Rotario/toolTorque/Orders.xlsx

Part | Value | Device | Package | Description
C1 | 0.1uF | 0.1UF-25V-5%(0603) | 0603-CAP | CAP-08604
C2 | 0.1uF | 0.1UF-25V-5%(0603) | 0603-CAP | CAP-08604 | M | 11 | 81-GRM033R60J104JE9D | GRM033R60J104JE19D | Murata | Multilayer Ceramic Capacitors MLCC - SMD/SMT .1UF 6.3V 5% 0201 | RoHS Compliant |  | 4 | £0.082 | £0.33
C3 | 0.1uF | 0.1UF-25V-5%(0603) | 0603-CAP | CAP-08604
C5 | 0.1uF | 0.1UF-25V-5%(0603) | 0603-CAP | CAP-08604
C6 | 10uF | 10UF50V20%(1210) | 1210 | CAP-09824 | M | 12 | 963-EMK325BJ106MN-T | EMK325BJ106MN-T | Taiyo Yuden | Multilayer Ceramic Capacitors MLCC - SMD/SMT 1210 16VDC 10uF 20% X5R | RoHS Compliant |  | 2 | £0.295 | £0.59
C7 | 10uF | 10UF50V20%(1210) | 1210 | CAP-09824
J1 | DCJ0202 | DCJ0202 | DCJ0202 | DC POWER JACK | M | 10 | 502-RAPC722BKZ | RAPC722BKZ | Switchcraft | DC Power Connectors BKZ Locking Series 2.0mm RAPC Mount | RoHS Compliant | New Product | 3 | £1.87 | £5.61
JP2 | 53047-0210 | 53047-0210 | 53047-0210 | Molex Picoblade 3 way PCB Header
L1 | 3.3uH | INDUCTOR0805-IND | 805 | Inductors | M | 13 | 810-KLZ2012MHR3R3HTD | KLZ2012MHR3R3HTD25 | TDK | Fixed Inductors 3.3uH 2MHz 20% 2012 AEC-Q200 | RoHS Compliant |  | 1 | £0.254 | £0.25
Q1 | MMBT4403 | TRANSISTOR_PNPMMBT4403 | SOT23-3 | Generic PNP BJT
R1 | 20k | 20KOHM1/10W1%(0603) | 0603-RES | RES-09383 | M | 14 | 660-RN73R1JTD2002B25 | RN73R1JTTD2002B25 | KOA Speer | Thin Film Resistors - SMD 20K ohm 0.1% 25 ppm | RoHS Compliant | New Product | 1 | £0.385 | £0.39
R2 | 8.2K | 8.2KOHM-1/10W-5%(0603) | 0603-RES | RES-10646 | M | 15 | 71-CRCW06038K20FKEAC | CRCW06038K20FKEAC | Vishay | Thick Film Resistors - SMD 1/10Watt 8.2Kohms 1% Commercial Use | RoHS Compliant By Exemption | New Product | 1 | £0.131 | £0.13
R3 | 100 | 100OHM-1/10W-1%(0603) | 0603-RES | RES-07863 | M | 16 | 71-CRCW0603100RJNEAC | CRCW0603100RJNEAC | Vishay | Thick Film Resistors - SMD 1/10Watt 100ohms 5% Commercial Use | RoHS Compliant By Exemption | New Product | 2 | £0.082 | £0.16
R4 | 100 | 100OHM-1/10W-1%(0603) | 0603-RES | RES-07863
R5 | 10K | 10KOHM-1/10W-1%(0603)0603 | 0603-RES | RES-00824 | M | 17 | 71-CRCW060310K0FKEAC | CRCW060310K0FKEAC | Vishay | Thick Film Resistors - SMD 1/10Watt 10Kohms 1% Commercial Use | RoHS Compliant By Exemption | New Product | 1 | £0.123 | £0.12
SG2 | EFBRD24C411 | EFBRD24C411 | RS511-7620 | Piezoelectric Acoustic Transducer
SJ2 |  | JUMPER-PAD-2-NC_BY_TRACE | PAD-JUMPER-2-NC_BY_TRACE_YES_SILK
SW1 |  | SW_DIP-2 | EDG-02 | DIP SWITCH | M | 4 | 653-A6FR-2104 | A6FR-2104 | Omron | DIP Switches/SIP Switches 2 Pole Long Actuator (white) | RoHS Compliant | New Product | 3 | £0.631 | £1.89
U$1 | 53047-0410 | 53047-0410 | 53047-0410 | Molex Picoblade 4 way PCB Header
U$2 | WEMOS-D1-MINI | WEMOS-D1-MINI | WEMOS-D1-MINI | WEMOS D1 mini: Mini Wi-Fi Board based on ESP-8266 device
U1 | HX711 | HX711HX711 | SO16 |  |  |  |  |  |  | IC-12445 |  | HX711
X1 | (4DSYSTEMS)FH12-30S-0.5SH | (4DSYSTEMS)FH12-30S-0.5SH | FH12-30S-0.5SH | 0.5mm Pitch Connectors For FPC/FFC | M | 2 | 798-FH52E-30S0.5SH99 | FH52E-30S-0.5SH(99) | Hirose Electric | FFC & FPC Connectors 0.5MM 30P LNG MTL FITNG SMT VERT MNT | RoHS Compliant |  | 3 | £3.11 | £9.33
Stand off |  |  |  |  | M | 3 | 534-24283 | 24283 | Keystone Electronics | Standoffs & Spacers 4.5 HEX 10.0mm SS | RoHS Compliant |  | 12 | £1.11 | £13.32
Stand off screws |  |  |  |  | M | 9 | 608-RM2.5X6MM2701 | RM2.5x6MM 2701 | APM HEXSEAL | Screws & Fasteners | RoHS Compliant |  | 12 | £0.418 | £5.02
