Rotario/toolTorque/Mouser.xls

SHOPPING BASKET
This is not an invoice
11-Oct-19 05:20:31
 | Mouser No | Mfr. No | Manufacturer | Customer No | Description | RoHS | Lifecycle | Order Qty. | Price (GBP) | Ext.: (GBP)
1 | 649-52601-S10-8LF | 52601-S10-8LF | FCI / Amphenol |  | Headers & Wire Housings LOW PROFILE .100 SHRD HDR | RoHS Compliant |  | 5 | £1.81 | £9.05
2 | 798-FH52E-30S0.5SH99 | FH52E-30S-0.5SH(99) | Hirose Electric |  | FFC & FPC Connectors 0.5MM 30P LNG MTL FITNG SMT VERT MNT | RoHS Compliant |  | 3 | £3.11 | £9.33
3 | 534-24283 | 24283 | Keystone Electronics |  | Standoffs & Spacers 4.5 HEX 10.0mm SS | RoHS Compliant |  | 12 | £1.11 | £13.32
4 | 653-A6FR-2104 | A6FR-2104 | Omron |  | DIP Switches/SIP Switches 2 Pole Long Actuator (white) | RoHS Compliant | New Product | 3 | £0.631 | £1.89
5 | 474-TOL-14557 | TOL-14557 | SparkFun Electronics |  | SparkFun Accessories Hot-Air Rework Station - 303D | RoHS Compliant | New At Mouser | 1 | £106.47 | £106.47
6 | 578-EROP7SA | EROP7SA | Apex Tool Group |  | Pliers & Tweezers Erem 4.5" Tweezers Micro-fine Curved | Not Applicable |  | 1 | £3.94 | £3.94
7 | 590-811-100 | 811-100 | MG Chemicals |  | Chemicals COTTON SWABS (DOUBLE 100 PCS PER PKG | Not Applicable |  | 1 | £4.38 | £4.38
8 | 910-TS391AX50 | TS391AX50 | Chip Quik |  | Solder Paste No-Clean 50g Sn63/Pb37 T4 |  |  | 1 | £11.43 | £11.43
9 | 608-RM2.5X6MM2701 | RM2.5x6MM 2701 | APM HEXSEAL |  | Screws & Fasteners | RoHS Compliant |  | 12 | £0.418 | £5.02
10 | 502-RAPC722BKZ | RAPC722BKZ | Switchcraft |  | DC Power Connectors BKZ Locking Series 2.0mm RAPC Mount | RoHS Compliant | New Product | 3 | £1.87 | £5.61
11 | 81-GRM033R60J104JE9D | GRM033R60J104JE19D | Murata |  | Multilayer Ceramic Capacitors MLCC - SMD/SMT .1UF 6.3V 5% 0201 | RoHS Compliant |  | 4 | £0.082 | £0.33
12 | 963-EMK325BJ106MN-T | EMK325BJ106MN-T | Taiyo Yuden |  | Multilayer Ceramic Capacitors MLCC - SMD/SMT 1210 16VDC 10uF 20% X5R | RoHS Compliant |  | 2 | £0.295 | £0.59
13 | 810-KLZ2012MHR3R3HTD | KLZ2012MHR3R3HTD25 | TDK |  | Fixed Inductors 3.3uH 2MHz 20% 2012 AEC-Q200 | RoHS Compliant |  | 1 | £0.254 | £0.25
14 | 660-RN73R1JTD2002B25 | RN73R1JTTD2002B25 | KOA Speer |  | Thin Film Resistors - SMD 20K ohm 0.1% 25 ppm | RoHS Compliant | New Product | 1 | £0.385 | £0.39
15 | 71-CRCW06038K20FKEAC | CRCW06038K20FKEAC | Vishay |  | Thick Film Resistors - SMD 1/10Watt 8.2Kohms 1% Commercial Use | RoHS Compliant By Exemption | New Product | 1 | £0.131 | £0.13
16 | 71-CRCW0603100RJNEAC | CRCW0603100RJNEAC | Vishay |  | Thick Film Resistors - SMD 1/10Watt 100ohms 5% Commercial Use | RoHS Compliant By Exemption | New Product | 2 | £0.082 | £0.16
17 | 71-CRCW060310K0FKEAC | CRCW060310K0FKEAC | Vishay |  | Thick Film Resistors - SMD 1/10Watt 10Kohms 1% Commercial Use | RoHS Compliant By Exemption | New Product | 1 | £0.123 | £0.12
By submitting your order you agree to these terms and conditions. (https://www.mouser.co.uk/saleterms) |  |  |  |  |  |  |  |  | Merchandise Total: | £172.41
Prices are reflected at the date and time shown. |  |  |  |  |  |  |  |  | Delivery Charge: | £0.00
 |  |  |  |  |  |  |  |  | Back-order Delivery: | Estimate
