Rotario/toolTorque/TorquePotSch_SINGLEBOARD.brd

## EAGLE design TorquePotSch_SINGLEBOARD.brd (2019-12-05)

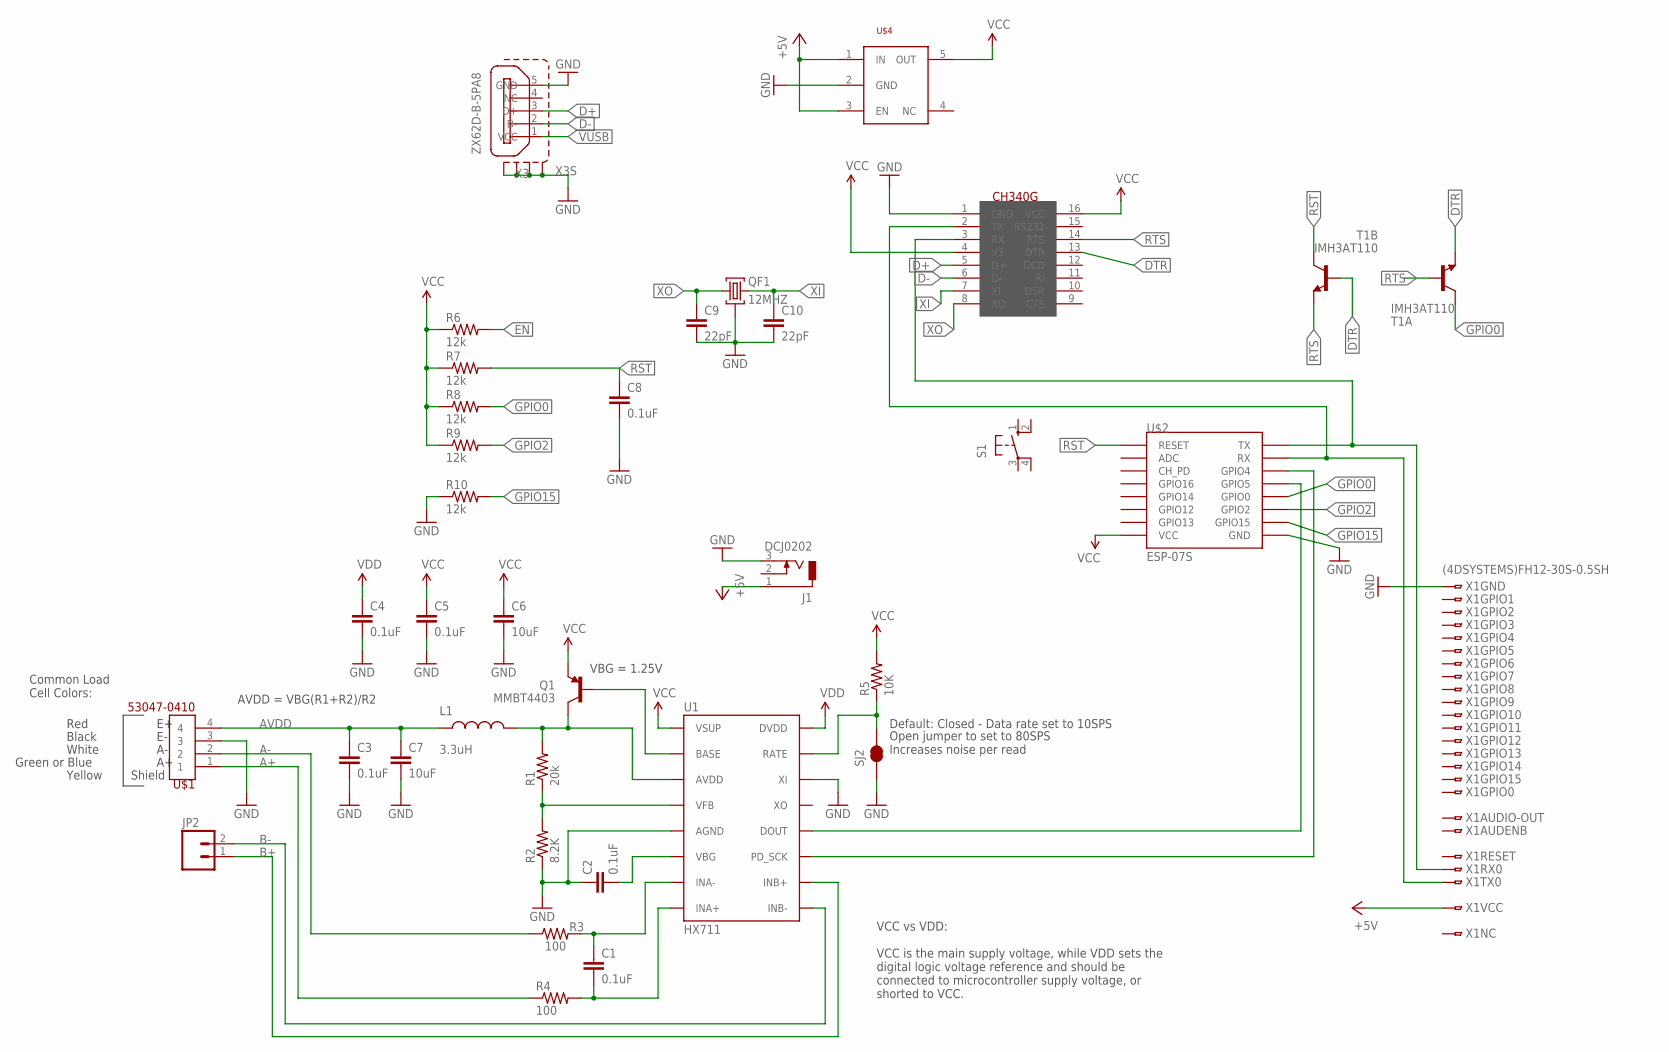
[picture p1: schematic TorquePotSch_SINGLEBOARD.sch]

Parts:
C1, C2, C3, C4, C5, C8: 0.1uF; 0603-CAP
C6, C7: 10uF; 1210
C9, C10: 22pF; 0603-CAP
J1: DCJ0202
JP2: M02PTH; 1X02
L1: 3.3uH; 0805
Q1: MMBT4403; SOT23-3
QF1: 12MHZ; HC49U
R1: 20k; 0603-RES
R2: 8.2K; 0603-RES
R3, R4: 100; 0603-RES
R5: 10K; 0603-RES
R6, R7, R8, R9, R10: 12k; R0805
S1: 10-XX; B3F-10XX
SJ2: JUMPER-PAD-2-NC_BY_TRACE; PAD-JUMPER-2-NC_BY_TRACE_YES_SILK
T1: IMH3AT110; SMT6
U1: HX711; SO16
U$1: 53047-0410
U$2: ESP-07S; ESP07S
U$3: CH340G; SOIC16
U$4: TLV755P; SOT23-5L
X1: (4DSYSTEMS)FH12-30S-0.5SH; FH12-30S-0.5SH
X3: ZX62D-B-5PA8

Connections:
+5V: J1.1, U$4.1 (IN), U$4.3 (EN), X1.26, X1.27
A+: R4.1, U$1.1
A-: R3.1, U$1.2
AVDD: C3.1, C7.1, L1.1, U$1.4
B+: JP2.1, U1.10 (INB+)
B-: JP2.2, U1.9 (INB-)
D+: U$3.5 (D+), X3.3 (D+)
D-: U$3.6 (D-), X3.2 (D-)
DTR: T1.6 (E), U$3.13 (DTR)
EN: R6.2
GND: C2.1, C3.2, C4.2, C5.2, C6.2, C7.2, C8.2, C9.2, C10.2, J1.3, QF1.2, R2.1, R10.1, SJ2.1, U1.5 (AGND), U1.14 (XI), U$1.3, U$2.GND, U$3.1 (GND), U$4.2 (GND), X1.1, X1.21, X1.25, X1.30, X3.5 (GND), X3.S1, X3.S2, X3.S3, X3.S4
GPIO0: R8.2, T1.1 (C), U$2.GPIO0
GPIO2: R9.2, U$2.GPIO2
GPIO15: R10.2, U$2.GPIO15
unnamed: R5.1, SJ2.2, U1.15 (RATE)
unnamed: C1.1, R3.2, U1.7 (INA-)
unnamed: C1.2, R4.2, U1.8 (INA+)
unnamed: Q1.1 (B), U1.2 (BASE)
unnamed: L1.2, Q1.3 (C), R1.2, U1.3 (AVDD)
unnamed: R1.1, R2.2, U1.4 (VFB)
unnamed: C2.2, U1.6 (VBG)
unnamed: U1.12 (DOUT), U$2.GPIO5
unnamed: U1.11 (PD_SCK), U$2.GPIO4
unnamed: U$2.TX, U$3.3 (RX), X1.23
unnamed: U$2.RX, U$3.2 (TX), X1.24
RST: C8.1, R7.2, U$2.REST (RESET)
RTS: U$3.14 (RTS)
VCC: C5.1, C6.1, Q1.2 (E), R5.2, R6.1, R7.1, R8.1, R9.1, U1.1 (VSUP), U$2.VCC, U$3.4 (V3), U$3.16 (VCC), U$4.5 (OUT)
VDD: C4.1, U1.16 (DVDD)
VUSB: X3.1 (VCC)
XI: C10.1, QF1.3, U$3.7 (XI)
XO: C9.1, QF1.1, U$3.8 (XO)

Notes on the sheet:
VBG = 1.25V
AVDD = VBG(R1+R2)/R2
Default: Closed - Data rate set to 10SPS
Open jumper to set to 80SPS Increases noise per read
Red
Black
White
Green or Blue
Common Load Cell Colors:
Shield
Yellow
VCC vs VDD: VCC is the main supply voltage, while VDD sets the digital logic voltage reference and should be connected to microcontroller supply voltage, or shorted to VCC.

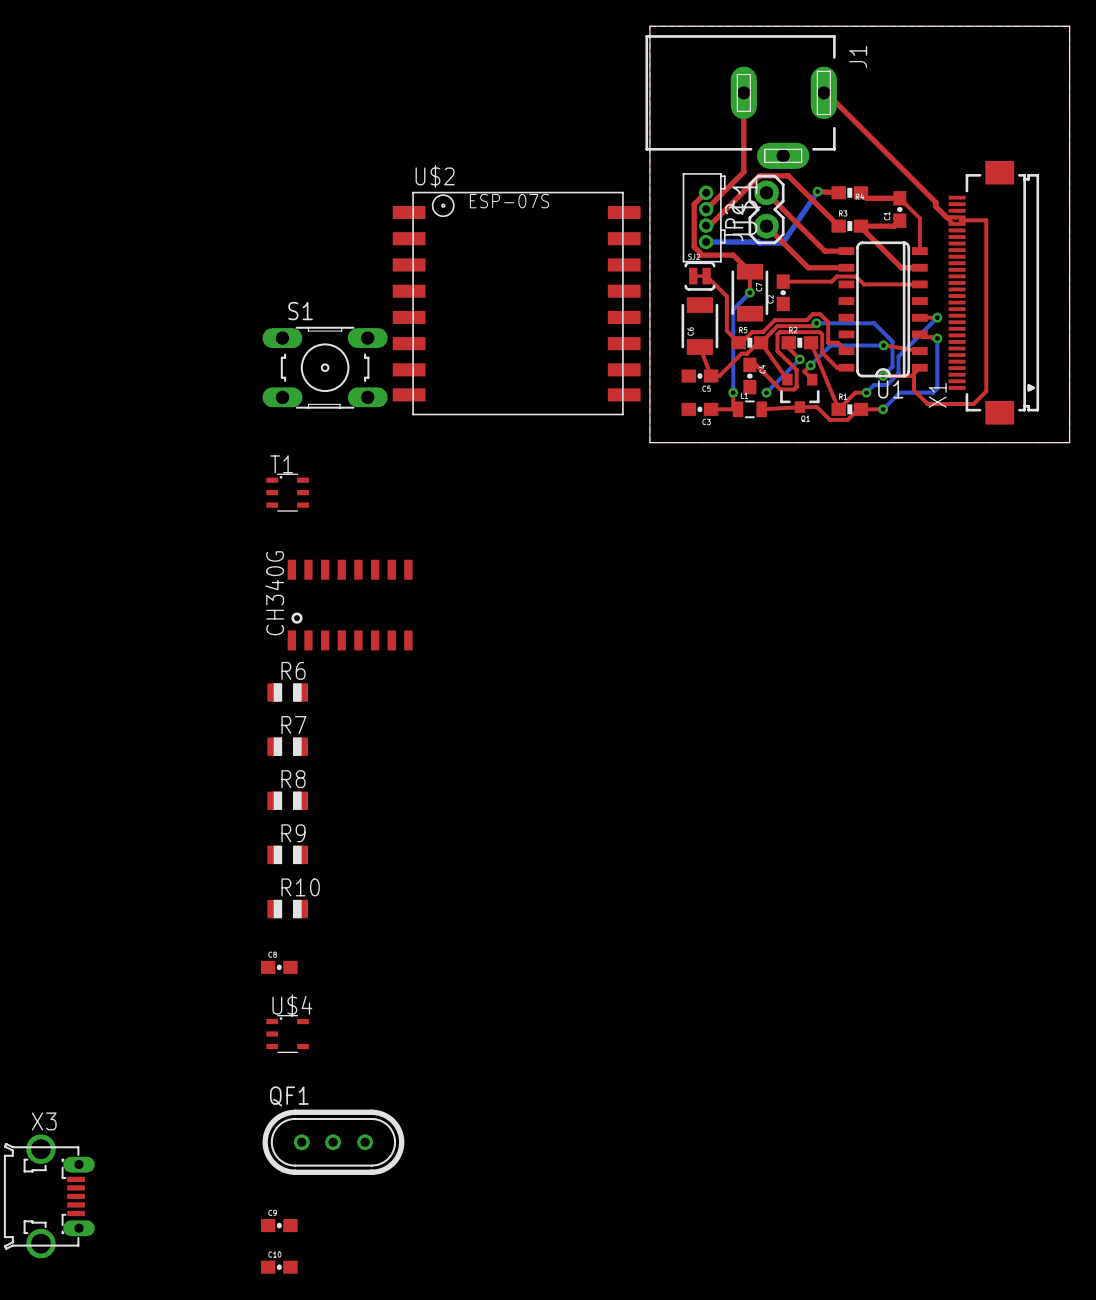
[picture p2: board TorquePotSch_SINGLEBOARD.brd from above]

Board: 2 copper layers, 32.0 x 31.8 mm, 35 parts (0 on the bottom side), 29 nets.
