Rotario/toolTorque/toolTorquePot/Screen02_SERVERuncompressed/serverHelpers.ino

/*__________________________________________________________SERVER_HANDLERS__________________________________________________________*/

void handleNotFound() { // if the requested file or page doesn't exist, return a 404 not found error
 if (server.uri().startsWith("/api/")){
   handleREST(server.uri().c_str());
  } else if (!handleFileRead(server.uri())) {        // check if the file exists in the flash memory (SPIFFS), if so, send it
    server.send(404, "text/plain", "404: File Not Found");
  }
}

bool handleFileRead(String path) { // send the right file to the client (if it exists)
  Serial1.println("handleFileRead: " + path);
  if (path.endsWith("/")) path += "index.html";          // If a folder is requested, send the index file
  String contentType = getContentType(path);             // Get the MIME type
  String pathWithGz = path + ".gz";
  if (SPIFFS.exists(pathWithGz) || SPIFFS.exists(path)) { // If the file exists, either as a compressed archive, or normal
    if (SPIFFS.exists(pathWithGz))                         // If there's a compressed version available
      path += ".gz";                                         // Use the compressed verion
    File file = SPIFFS.open(path, "r");                    // Open the file
    size_t sent = server.streamFile(file, contentType);    // Send it to the client
    file.close();                                          // Close the file again
    Serial1.println(String("\tSent file: ") + path);
    return true;
  }
  Serial1.println(String("\tFile Not Found: ") + path);   // If the file doesn't exist, return false
  return false;
}

void handleFileUpload() { // upload a new file to the SPIFFS
  HTTPUpload& upload = server.upload();
  String path;
  if (upload.status == UPLOAD_FILE_START) {
    path = upload.filename;
    if (!path.startsWith("/")) path = "/" + path;
    if (!path.endsWith(".gz")) {                         // The file server always prefers a compressed version of a file
      String pathWithGz = path + ".gz";                  // So if an uploaded file is not compressed, the existing compressed
      if (SPIFFS.exists(pathWithGz))                     // version of that file must be deleted (if it exists)
        SPIFFS.remove(pathWithGz);
    }
    Serial1.print("handleFileUpload Name: "); Serial1.println(path);
    fsUploadFile = SPIFFS.open(path, "w");            // Open the file for writing in SPIFFS (create if it doesn't exist)
    path = String();
  } else if (upload.status == UPLOAD_FILE_WRITE) {
    if (fsUploadFile)
      fsUploadFile.write(upload.buf, upload.currentSize); // Write the received bytes to the file
  } else if (upload.status == UPLOAD_FILE_END) {
    if (fsUploadFile) {                                   // If the file was successfully created
      fsUploadFile.close();                               // Close the file again
      Serial1.print("handleFileUpload Size: "); Serial1.println(upload.totalSize);
      server.sendHeader("Location", "/success.html");     // Redirect the client to the success page
      server.send(303);
    } else {
      server.send(500, "text/plain", "500: couldn't create file");
    }
  }
}

void handleREST(const char * path){
  // "variable requested is 5 chars right of path, assuming path starts with /api/
  char buf[50];
  snprintf(buf, 50, path+5);

  uint8_t idx;
  for (uint8_t i = 0; i < variable_index; i++){
    if (strcmp(buf, variable_names[i]) == 0){
      idx = i;
    } else {
      server.send(404, "text/plain", "404: Can't find resource specified");
      return;
    }
  }
  //TODO: Fix this, doesn't return torque val
  int length = snprintf(buf, 50, "{\"name\":\"%s\", \"data\":%i}", variable_names[idx], (int*)variables[idx]);
  server.send(200, "application/json", buf);
}

void webSocketEvent(uint8_t num, WStype_t type, uint8_t * payload, size_t lenght) { // When a WebSocket message is received
  switch (type) {
    case WStype_DISCONNECTED:             // if the websocket is disconnected
      Serial1.printf("[%u] Disconnected!\n", num);
      break;
    case WStype_CONNECTED: {              // if a new websocket connection is established
        IPAddress ip = webSocket.remoteIP(num);
        Serial1.printf("[%u] Connected from %d.%d.%d.%d url: %s\n", num, ip[0], ip[1], ip[2], ip[3], payload);
        updateWebsocketStrings();
        //rainbow = false;                  // Turn rainbow off when a new connection is established
      }
      break;
    case WStype_TEXT:                     // if new text data is received 
      Serial1.printf("[%u] get Text: %s\n", num, payload);
      /*if (payload[0] == '#') {            // we get RGB data
        uint32_t rgb = (uint32_t) strtol((const char *) &payload[1], NULL, 16);   // decode rgb data
        int r = ((rgb >> 20) & 0x3FF);                     // 10 bits per color, so R: bits 20-29
        int g = ((rgb >> 10) & 0x3FF);                     // G: bits 10-19
        int b =          rgb & 0x3FF;                      // B: bits  0-9

        analogWrite(LED_RED,   r);                         // write it to the LED output pins
        analogWrite(LED_GREEN, g);
        analogWrite(LED_BLUE,  b);
        } else if (payload[0] == 'R') {                      // the browser sends an R when the rainbow effect is enabled
        rainbow = true;
        } else if (payload[0] == 'N') {                      // the browser sends an N when the rainbow effect is disabled
        rainbow = false;
        }*/
      break;
  }
}

/*__________________________________________________________HELPER_FUNCTIONS__________________________________________________________*/

String formatBytes(size_t bytes) { // convert sizes in bytes to KB and MB
  if (bytes < 1024) {
    return String(bytes) + "B";
  } else if (bytes < (1024 * 1024)) {
    return String(bytes / 1024.0) + "KB";
  } else if (bytes < (1024 * 1024 * 1024)) {
    return String(bytes / 1024.0 / 1024.0) + "MB";
  }
}

String getContentType(String filename) { // determine the filetype of a given filename, based on the extension
  if (filename.endsWith(".html")) return "text/html";
  else if (filename.endsWith(".css")) return "text/css";
  else if (filename.endsWith(".js")) return "application/javascript";
  else if (filename.endsWith(".ico")) return "image/x-icon";
  else if (filename.endsWith(".gz")) return "application/x-gzip";
  return "text/plain";
}
